BenSuskins/display/design/print/case-exploded.png

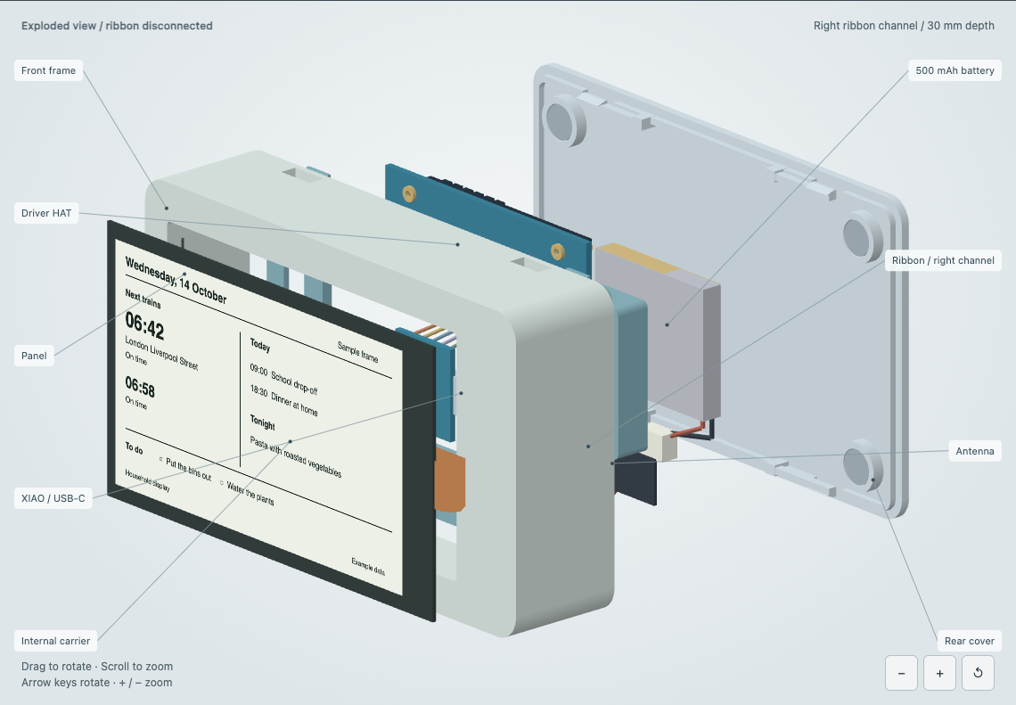
design/print/case-exploded.png
