BenSuskins/display/design/case-mockup.html

# Household display

A magnetic case. Three printed parts. One removable cover.

Fit prototype

## Inspect the case

FrontRearSideExploded Release slots

Transparent shellPart labelsClip section

## Fixed dimensions

120 × 74 × 30 mm

Outer width × height × depth

Panel and ribbon allowance: about 110 × 62 mm. The right border hides the ribbon channel.

What needs a measurement?

The glass body is 105.33 × 62.37 mm. Its visible area is 92.8 × 55.68 mm. The model uses the drawing’s offset.

Confirm header plugs, wire bends, the ribbon route, antenna size, and battery connector before CAD.

The 30 mm depth includes both walls. It does not prove the assembled hardware fits.

## Inside the case

- Front frame
- Internal carrier
- Rear cover
- Driver HAT and XIAO
- Panel ribbon
- 500 mAh battery

## Access from the rear

Remove the device from the fridge. Insert a small plastic tool through each release slot. Press the clip toward the centre and lift the cover edge. Two slots sit on top; two sit underneath. Open the cover to reach USB-C, RESET, and BOOT. The carrier holds the panel and electronics.

Clip sizes and magnet strength need checks for the chosen print material. The printed parts in this view use the exported CAD geometry. Validate the first print before fitting the panel.

Perspective viewRight ribbon channel / 30 mm depth

Drag to rotate · Scroll to zoom
Arrow keys rotate · + / − zoom

−+↺

## Case assembled

Step 6 of 6

PartsPanelCarrierElectronicsCoverLocked

Previous Play assemblyNextResetOpen cover

Copy design brief

## How the cover clip works

Close

### Clip locked

The hook sits behind the retaining ledge. The arm returns to its resting position.

Close clipRelease clipReplay closure

Section enlarged for clarity. The CAD clip has a long arm along the cover edge. This section illustrates the hook movement. The print material sets the final dimensions and clearance.
