BenSuskins/display/design/print/low-material/case-exploded.png

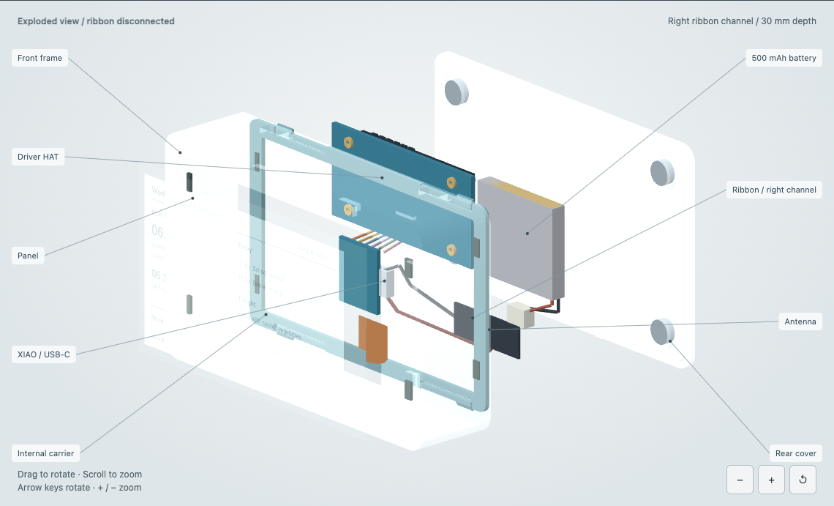
design/print/low-material/case-exploded.png
