BenSuskins/display/design/print/low-material/case-rear.png

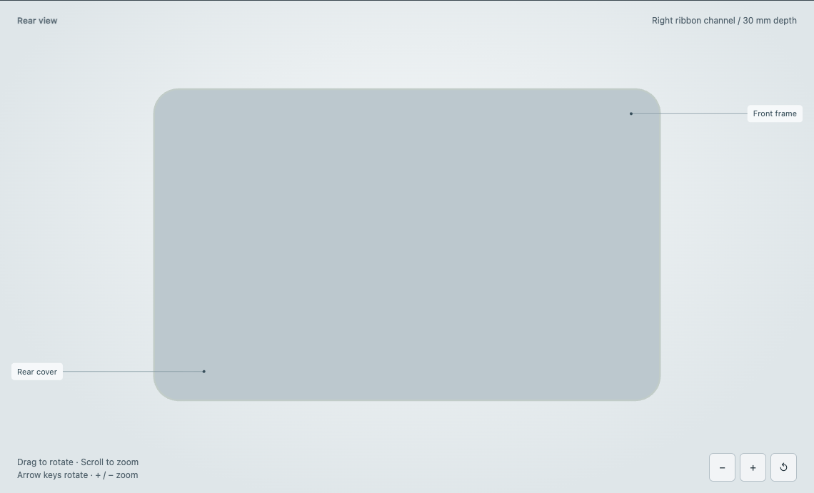
design/print/low-material/case-rear.png
