BenSuskins/display/design/print/low-material/case-assembly.step

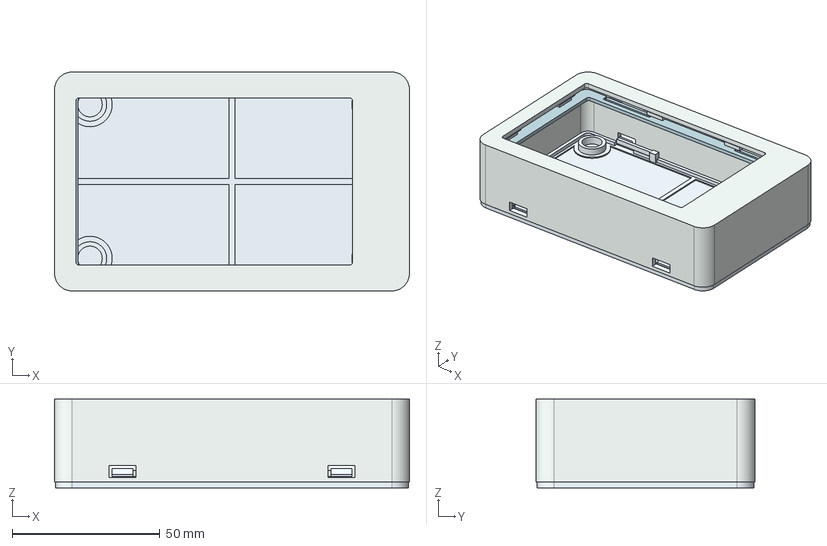
[picture p4: CAD file, 2026-10-15]
design/print/low-material/case-assembly.step
120.0 x 74.0 x 30.0 mm
front-frame
internal-carrier
rear-cover
