BenSuskins/display/design/print/case-assembly.step

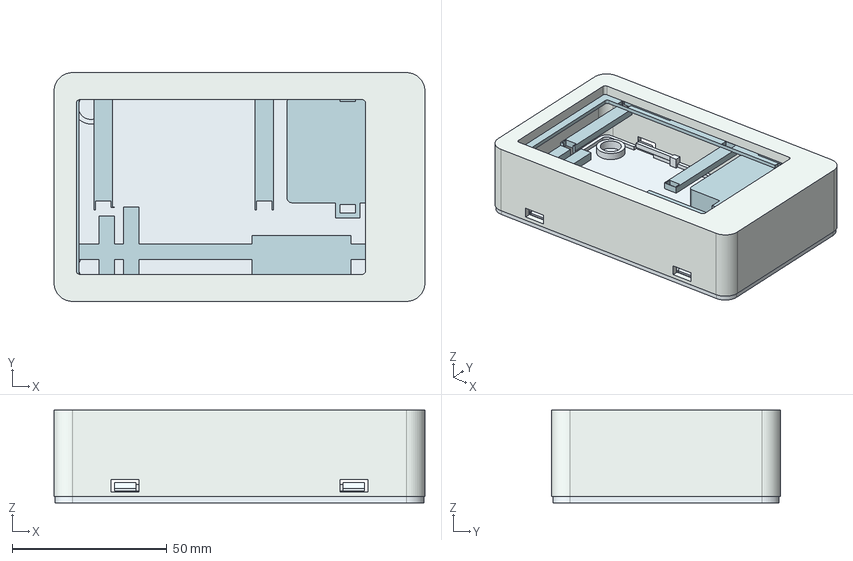
[picture p5: CAD file, 2026-10-14]
design/print/case-assembly.step
120.0 x 74.0 x 30.0 mm
front-frame
internal-carrier
rear-cover
