BenSuskins/display/design/print/all-parts.stl

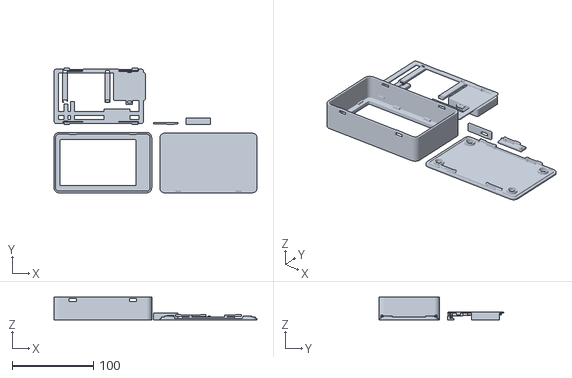
[picture p6: CAD file, 2026-10-14]
design/print/all-parts.stl
249.2 x 153.0 x 28.0
