BenSuskins/display/design/print/low-material/all-parts.stl

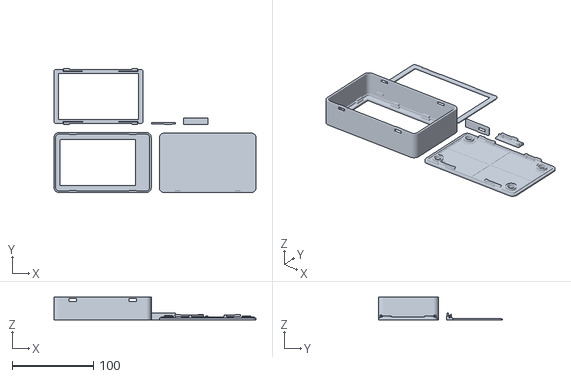
[picture p7: CAD file, 2026-10-15]
design/print/low-material/all-parts.stl
249.2 x 153.0 x 28.0
