BenSuskins/display/design/print/clip-coupon-cover.step

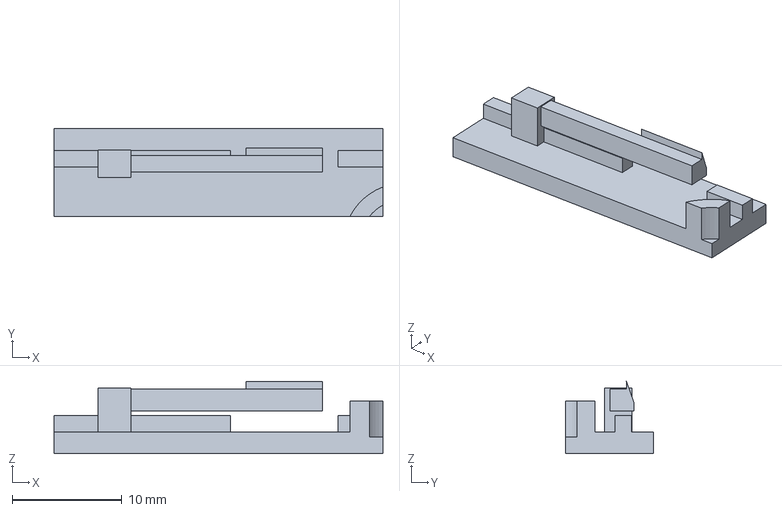
[picture p8: CAD file, 2026-10-14]
design/print/clip-coupon-cover.step
30.0 x 8.00 x 6.60 mm
