BenSuskins/display/design/print/low-material/front-frame.step

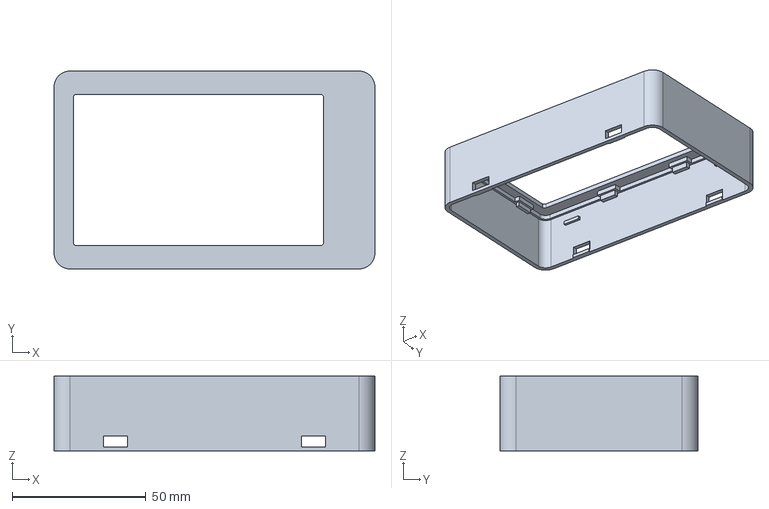
[picture p9: CAD file, 2026-10-15]
design/print/low-material/front-frame.step
120.0 x 74.0 x 28.0 mm
