BenSuskins/display/design/print/low-material/clip-coupon-frame.step

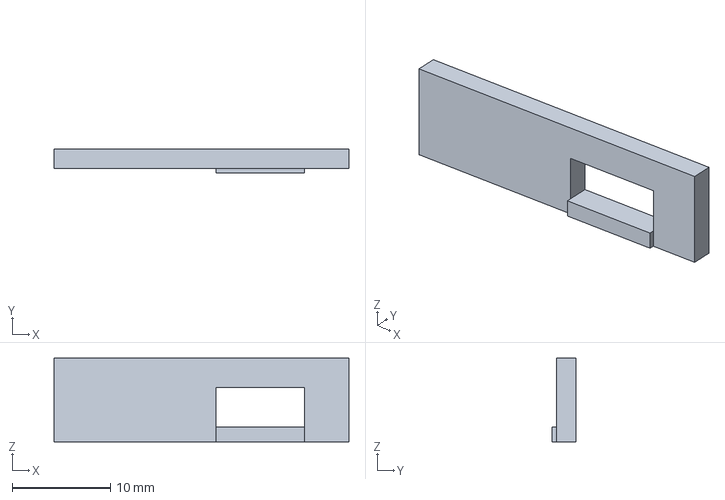
[picture p10: CAD file, 2026-10-15]
design/print/low-material/clip-coupon-frame.step
30.0 x 2.45 x 8.50 mm
