BenSuskins/display/design/print/rear-cover.step

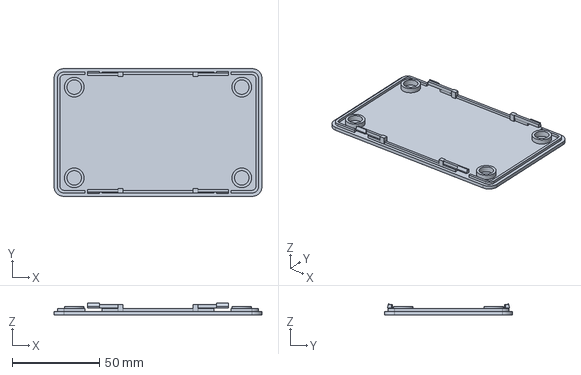
[picture p11: CAD file, 2026-10-14]
design/print/rear-cover.step
119.2 x 73.2 x 6.60 mm
