BenSuskins/display/design/print/internal-carrier.step

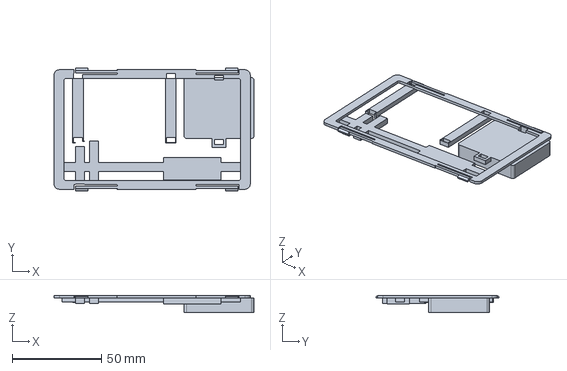
[picture p12: CAD file, 2026-10-14]
design/print/internal-carrier.step
112.1 x 69.0 x 9.80 mm
