BenSuskins/display/design/print/low-material/internal-carrier.step

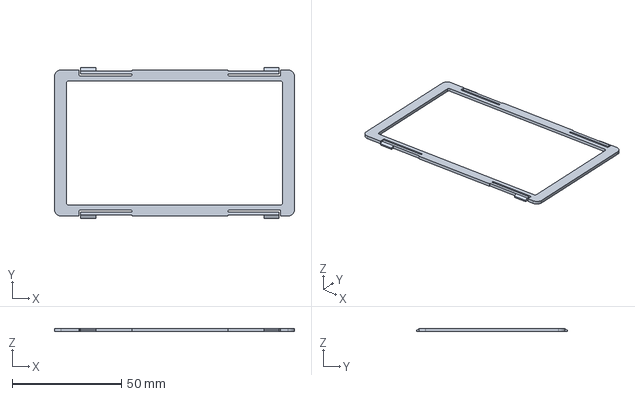
[picture p13: CAD file, 2026-10-15]
design/print/low-material/internal-carrier.step
110.0 x 69.0 x 1.50 mm
