BenSuskins/display/(list of files, cad)

Other CAD files:
design/print/clip-coupon-frame.step
design/print/low-material/rear-cover.step
design/print/front-frame.step
design/print/low-material/clip-coupon-cover.step
design/print/clip-coupon-cover.stl
design/print/front-frame.stl
design/print/internal-carrier.stl
design/print/low-material/clip-coupon-cover.stl
design/print/low-material/clip-coupon-frame.stl
design/print/low-material/front-frame.stl
design/print/low-material/internal-carrier.stl
design/print/low-material/rear-cover.stl
design/print/rear-cover.stl
