BenSuskins/display/design/print/case-preview.png

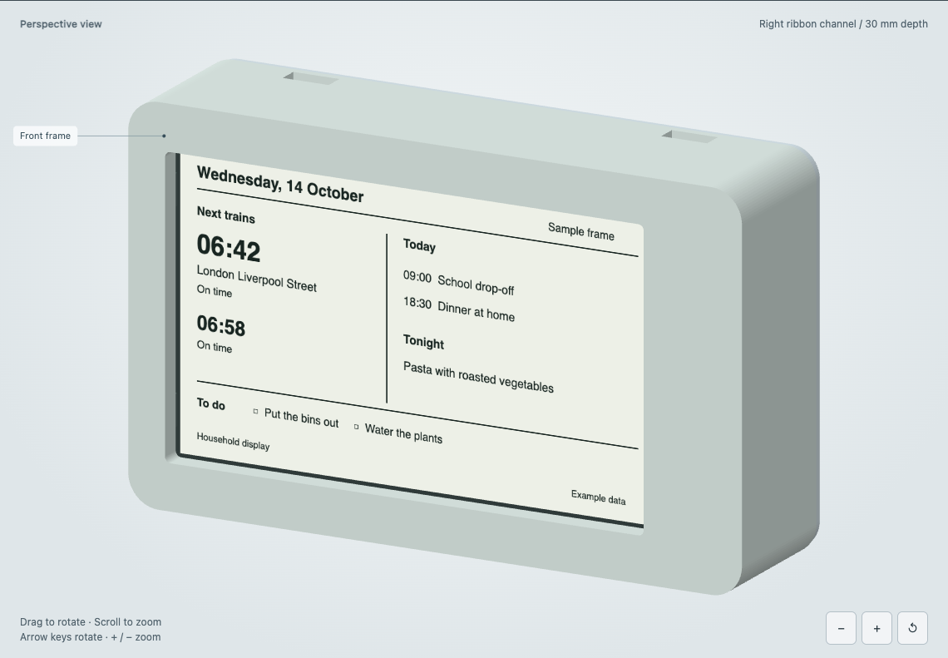
design/print/case-preview.png
