BenSuskins/display/apps/firmware/src/main.cpp

#include <Arduino.h>
#include <esp_sleep.h>
#include <esp_system.h>
#include <driver/gpio.h>
#include <gdeq/GxEPD2_426_GDEQ0426T82.h>

#include "DisplayPins.h"
#include "Frame.h"
#include "FrameClient.h"
#include "OfflineMarker.h"

// The whole of the Device's behaviour. It owns no layout, no schedule and no
// household data — it fetches a Frame, shows it, and sleeps for as long as the
// Render Service tells it to. See docs/adr/0001 and 0002.

// Caught here rather than at runtime: an unset environment variable expands to
// an empty string, and a device flashed with one fails in a way that looks like
// a network fault from across the room.
static_assert(sizeof(WIFI_SSID) > 1, "WIFI_SSID must be set when building");
static_assert(sizeof(WIFI_PASSWORD) > 1,
              "WIFI_PASSWORD must be set when building");
static_assert(sizeof(FRAME_URL) > 1, "FRAME_URL must be set when building");
static_assert(sizeof(DEVICE_TOKEN) > 1,
              "DEVICE_TOKEN must be set when building");

// Bisected on working hardware: 4 s truncates a full refresh and blanks the
// screen, 8 s completes it. Well above the observed edge, because e-ink slows
// as it cools and a truncated refresh fails silently.
constexpr uint32_t FullRefreshGuardMilliseconds = 12000;

// PROVISIONAL. The library claims 600 ms for a partial refresh, but BUSY tells
// us nothing on this HAT so it has never been bisected here. Run the
// partial_probe environment and replace this with a measured number before
// trusting the Offline Marker.
constexpr uint32_t PartialRefreshGuardMilliseconds = 3000;

constexpr uint32_t FailuresBeforeOfflineMarker = 3;
constexpr uint32_t FallbackSleepSeconds = 1800;
constexpr uint32_t MaximumSleepSeconds = 3600;

// Survives deep sleep. The etag is what makes a 304 possible, and losing it
// costs one unnecessary redraw, nothing worse.
RTC_DATA_ATTR char shownEtag[Frame::EtagCapacity] = {0};
RTC_DATA_ATTR uint32_t consecutiveFailures = 0;
RTC_DATA_ATTR bool offlineMarkerShown = false;
RTC_DATA_ATTR uint32_t wakeCount = 0;

// 48 KB in .bss. Talking to the driver directly rather than through GxEPD2_BW
// avoids a second buffer of the same size that we would never draw into.
static uint8_t frameBuffer[Frame::ByteLength];

GxEPD2_426_GDEQ0426T82 panel(DisplayPins::ChipSelect, DisplayPins::DataCommand,
                             DisplayPins::Reset, DisplayPins::Busy);

// The XIAO's RESET button is a usable Requested Wake without wiring anything:
// it pulls EN low, so the chip boots straight into a fetch and a render. It
// resets the RTC domain too, which clears the stored etag — so a reset press
// always redraws rather than getting a 304. That is the right behaviour for
// someone who just pressed refresh.
//
// The BOOT button cannot be used. It is GPIO9, outside the GPIO0-5 range the
// ESP32-C3 can wake from deep sleep on, and holding it at reset selects
// download mode instead of running this firmware.
const char *wakeCauseLabel() {
  switch (esp_sleep_get_wakeup_cause()) {
    case ESP_SLEEP_WAKEUP_GPIO:
      return "button";
    case ESP_SLEEP_WAKEUP_TIMER:
      return "timer";
    default:
      break;
  }

  return esp_reset_reason() == ESP_RST_POWERON ? "power on" : "reset";
}

// A Requested Wake from a button between D3 and GND.
//
// Off until WAKE_BUTTON_WIRED is defined, because arming a deep-sleep wake on an
// unconnected pin invites spurious wakes — a floating pin on this bench picks up
// mains hum. RESET remains the manual refresh either way and needs none of this.
//
// The pullup has to be held explicitly. pinMode(INPUT_PULLUP) configures the
// digital pad for normal operation only; without the hold it is not guaranteed
// through deep sleep, and an unheld pullup is the same as no pullup. The C3 has
// no rtc_gpio_pullup_en — that API does not exist on this chip.
void armButtonWake() {
#ifdef WAKE_BUTTON_WIRED
  constexpr gpio_num_t button =
      static_cast<gpio_num_t>(DisplayPins::WakeButton);

  gpio_pullup_en(button);
  gpio_pulldown_dis(button);
  gpio_hold_en(button);
  gpio_deep_sleep_hold_en();

  esp_deep_sleep_enable_gpio_wakeup(1ULL << button, ESP_GPIO_WAKEUP_GPIO_LOW);
#endif
}

// Pad holds survive the wake, so they have to be let go before anything is
// reconfigured — PanelPower in particular is driven low before sleeping.
void releaseHeldPins() {
#ifdef WAKE_BUTTON_WIRED
  gpio_deep_sleep_hold_dis();
  gpio_hold_dis(static_cast<gpio_num_t>(DisplayPins::WakeButton));
#endif
}

void powerPanelUp() {
  pinMode(DisplayPins::PanelPower, OUTPUT);
  digitalWrite(DisplayPins::PanelPower, HIGH);
  delay(100);

  // `initial` must be false. With it true, GxEPD2 sets _initial_write, and the
  // first writeImage silently calls clearScreen() — a whole extra full refresh
  // to white, which the library waits only full_refresh_time (1600 ms) for
  // because BUSY tells it nothing here. This panel needs ~8 s. Our image
  // refresh then lands 1.6 s into that clear and both are lost.
  //
  // Deep sleep restarts the sketch, so this object is fresh on every wake and
  // the fault would repeat on every redraw, not just the first.
  //
  // Skipping the clear is safe: we overwrite all 800x480 pixels anyway, and a
  // full refresh drives every pixel regardless of what was there.
  panel.init(115200, false, 10, false);
}

void showFrame() {
  // Writes the frame to both the previous and current controller buffers, so
  // one refresh leaves them equal — which is what a later partial refresh, and
  // therefore the Offline Marker, differentiates against.
  panel.writeImageForFullRefresh(frameBuffer, 0, 0, Frame::Width,
                                 Frame::Height);
  panel.refresh(false);
  delay(FullRefreshGuardMilliseconds);
}

void stampOfflineMarker() {
  // Tell the controller what was there before, because after a cold power-up it
  // has no idea and a partial refresh is differential. See OfflineMarker.h.
  panel.writeImageToPrevious(OfflineMarker::WhiteTile, OfflineMarker::X,
                             OfflineMarker::Y, OfflineMarker::Width,
                             OfflineMarker::Height);
  panel.writeImage(OfflineMarker::Bitmap, OfflineMarker::X, OfflineMarker::Y,
                   OfflineMarker::Width, OfflineMarker::Height);
  panel.refresh(OfflineMarker::X, OfflineMarker::Y, OfflineMarker::Width,
                OfflineMarker::Height);
  delay(PartialRefreshGuardMilliseconds);

  offlineMarkerShown = true;
  Serial.println("panel: offline marker stamped");
}

void sleepFor(uint32_t seconds) {
  const uint32_t bounded =
      seconds == 0 ? FallbackSleepSeconds
                   : (seconds > MaximumSleepSeconds ? MaximumSleepSeconds
                                                    : seconds);

  panel.hibernate();
  digitalWrite(DisplayPins::PanelPower, LOW);

  armButtonWake();
  esp_sleep_enable_timer_wakeup(static_cast<uint64_t>(bounded) * 1000000ULL);

  Serial.printf("sleeping %lu s (awake %lu ms)\n", bounded, millis());
  Serial.flush();
  esp_deep_sleep_start();
}

void setup() {
  Serial.begin(115200);
  delay(200);
  releaseHeldPins();

  wakeCount += 1;
  Serial.printf("\nwake %lu (%s) build %s %s\n", wakeCount, wakeCauseLabel(),
                __DATE__, __TIME__);

  if (!FrameClient::joinNetwork(WIFI_SSID, WIFI_PASSWORD)) {
    consecutiveFailures += 1;
    powerPanelUp();
    if (consecutiveFailures >= FailuresBeforeOfflineMarker &&
        !offlineMarkerShown) {
      stampOfflineMarker();
    }
    sleepFor(FallbackSleepSeconds);
  }

  const FrameResponse response = FrameClient::fetchFrame(
      FRAME_URL, DEVICE_TOKEN, shownEtag, frameBuffer, Frame::ByteLength);
  FrameClient::leaveNetwork();

  switch (response.outcome) {
    case FetchOutcome::Rendered:
      consecutiveFailures = 0;
      powerPanelUp();
      showFrame();
      strlcpy(shownEtag, response.etag, Frame::EtagCapacity);
      offlineMarkerShown = false;
      break;

    case FetchOutcome::Unchanged:
      // The cheap path, and the common one: no panel power, no refresh guard.
      consecutiveFailures = 0;
      Serial.println("panel: unchanged, skipping refresh");
      break;

    case FetchOutcome::Failed:
      consecutiveFailures += 1;
      Serial.printf("fetch failed (%lu in a row)\n", consecutiveFailures);
      if (consecutiveFailures >= FailuresBeforeOfflineMarker &&
          !offlineMarkerShown) {
        powerPanelUp();
        stampOfflineMarker();
      }
      break;
  }

  sleepFor(response.nextWakeSeconds);
}

void loop() {}
