BenSuskins/display/(commit log)

2026-08-05 Add e-ink display bring-up for XIAO ESP32-C3 + Waveshare 4.26"
    PlatformIO project driving a Waveshare 4.26" 800x480 b/w panel via a
    Driver HAT rev2.3 using GxEPD2.
    Established so far:
    - PWR (HAT pin 12) must be driven high from D5 before the panel responds
    to anything. A floating enable makes every other symptom intermittent.
    - BUSY is unusable on this hardware: it reads a constant low whenever the
    panel is powered, so GxEPD2 polling returns immediately. Pinned to -1
    and refresh completion is gated by a fixed delay instead.
    - No brownout; the ESP completes a full render cycle cleanly.
    Outstanding: the panel refreshes but receives no image data, so
    fillScreen(BLACK) still lands on whi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
    [DisplayPins.h, main.cpp]
2026-08-05 Add README
    Status, hardware, wiring table, build commands, and the non-obvious
    findings from bring-up: PWR must be driven, BUSY is unusable, and an
    unchanged e-ink screen is not evidence a render succeeded.
    Claude-Session: https://claude.ai/code/session_011L8yAMgag92eoUrTM27x8D
2026-08-05 Working timer-driven e-ink display
    First end-to-end working state: renders on a 60s deep-sleep timer cycle
    with a wake counter surviving in RTC memory.
    Repinned to the production map. Control lines moved off D0-D3 so those
    stay available as deep-sleep wake sources, since the ESP32-C3 only wakes
    on GPIO0-GPIO5. D0 left unused because GPIO2 is a boot strapping pin and
    a button pulling it low at reset can force download mode.
    Refresh timing bisected on working hardware: 4s truncates the refresh and
    blanks the screen, 8s completes it. Committed at 12s, well above the
    observed edge, because e-ink slows as it cools and a truncated refresh
    fails silently — stale image, nothing in the logs.
    Awa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
    [DisplayPins.h, main.cpp]
2026-08-05 Add layout prototype: eight demo pages for type, tone and symbols
    Cycles through eight pages to work out what actually reads well on this
    panel before committing to a dashboard design: a typography ladder with
    measured ink heights, a comparison of the two routes past 24pt, shape and
    rule primitives, dither and hatch tone, a drawn symbol set, two dashboard
    mockups and chart marks.
    Page renderers take Adafruit_GFX rather than the GxEPD2 template, so layout
    code is independent of the panel and its paging loop.
    No deep sleep here. Holding PanelPower high for the whole session removes
    the truncated-refresh failure mode that the 12 s guard delay exists for, so
    pages can follow each other as fast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
    [DemoPage.h, DemoPages.cpp, main.cpp]
2026-08-08 Add contrast probe and document the Display Config switch finding
    A washed-out panel traced to the HAT's Display Config switch selecting the
    higher current-limiting resistor for the panel's boost converter. The starved
    booster underdrives the drive waveform, which kills hairlines, small text and
    dither while leaving large solid fills looking fine. The demo pages are almost
    entirely fine detail, so it showed up as unexplained general fadedness.
    The probe renders solid fields, which the demo pages structurally cannot: a
    solid black page, and the same page with a white box swept across three
    positions. That exposed a full-height pale band on whichever columns carried
    switching content, and the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
2026-08-08 Add the Render Service domain and the Huxley2 departure source
    Design decision: the ESP32 stops composing images. A TypeScript service
    aggregates household data, lays the page out in HTML/CSS and serves a
    48,000-byte 1-bit frame; the device blits it and sleeps. That moves layout,
    data and scheduling to a deployable, so changing the design stops meaning
    reflashing a battery device on a fridge. Recorded in docs/adr/.
    Domain so far:
    - Catchable Departure — the next trains you could still make if you left now,
    filtered on the earliest a train can possibly leave rather than its booked
    time, so a delay that buys you time keeps the train on screen.
    - Wake schedule — the service tells the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
2026-08-08 Add the rasteriser, the frame endpoint and a deployable container
    The pipeline now runs end to end: HTML in a headless Chromium, thresholded to
    one bit per pixel, packed into the panel's native RAM format and served over
    HTTP with the sleep duration the device should obey.
    - packMonochrome — a set bit is white, most significant bit leftmost, which is
    what GxEPD2 expects (its clearScreen defaults to 0xFF for white), so the
    device hands the buffer straight to writeImage without touching it. Rows pad
    with white rather than black so an odd width can never draw a sliver.
    - rasteriser — Chromium is launched once and kept, because launching costs far
    more than rendering does. Playwrigh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
2026-08-08 Rewrite the firmware as a frame client, add the offline marker
    The device now does one thing per wake: join Wi-Fi, ask for a frame, write it
    to the panel if it changed, sleep for as long as the server said. No layout, no
    schedule, no clock, no household data — ADR-0001 and ADR-0002 made concrete.
    Talks to the GxEPD2 driver class directly rather than through GxEPD2_BW, which
    statically allocates its own 48 KB page buffer. On top of the downloaded frame
    that would be 96 KB of a 320 KB heap, for a buffer we never draw into. Build is
    26.8% RAM as it stands.
    - The etag lives in RTC memory, so an unchanged frame is a 304 and the panel
    refresh — and its 12 s blind guard — is skipped entir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
    [DemoMain.cpp, Frame.h, FrameClient.cpp, FrameClient.h, OfflineMarker.h, PartialRefreshProbe.cpp, main.cpp]
2026-08-08 Make the published host port configurable
    The container listens on 8080, but the host port it is published on is a
    deployment choice — and it is the one the device's FRAME_URL has to match.
    Hardcoding 8080 meant any other choice silently pointed the device at nothing.
    Claude-Session: https://claude.ai/code/session_01LEFtmreWUpF69a5c2e2E1y
2026-08-08 Fix the frame identity ticking with the wall clock
    The etag was a hash of the rendered bytes, and the footer prints "rendered
    HH:MM". Every minute produced a different etag, so If-None-Match would never
    have matched and the device would have redrawn on every wake — losing the
    entire battery argument for waking often that ADR-0002 rests on. The battery
    voltage in the footer did the same thing.
    Found from a live response header, not from the tests: every existing test
    injects a fixed clock, and the earlier manual curl check happened to run twice
    inside the same minute.
    The identity is now a hash of the page rendered at local midnight with the
    battery omitted, so the date still counts but t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
2026-08-08 Fix the blank panel: GxEPD2 was issuing a hidden second refresh
    The panel stayed blank on the first hardware run. Cause was init(115200, true,
    2, false): the `initial` argument sets _initial_write, and GxEPD2's _writeImage
    then silently calls clearScreen() before writing anything — an entire extra
    full refresh to white. The library waits full_refresh_time (1600 ms) for it,
    because BUSY carries no signal on this HAT and _waitWhileBusy falls back to a
    fixed delay. This panel needs about 8 s. So the clear was truncated and our
    image refresh landed 1.6 s into it, losing both.
    Deep sleep restarts the sketch, so the driver object is fresh on every wake and
    this would have repeated on every redr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
    [OfflineMarker.h, main.cpp]
2026-08-08 Drop the battery reading from the display
    It was never populated — the XIAO C3 has no divider from the battery pads to an
    ADC pin — and a reading that drifted every wake would have changed the frame's
    identity and cost a redraw every time, which is the same trap the footer clock
    set. The server still accepts ?battery= and still stretches the sleep interval
    when it is low; that is a scheduling input, not something to look at.
    batteryVolts therefore leaves the view model entirely rather than lingering
    unused, which also simplifies the frame identity: it now only has to hold the
    clock still.
    Also report the wake cause honestly. The XIAO's RESET button works as a manual
    refresh with no wir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
    [main.cpp]
2026-08-08 Gate button wake behind a flag, and hold its pullup properly
    Two things were wrong with arming a deep-sleep wake on D3.
    Nothing is connected to it, so the pin floats — and this bench is already
    documented as picking up mains hum on floating pins. A spurious wake costs a
    full fetch for nothing. It is now off unless WAKE_BUTTON_WIRED is defined.
    More subtly, pinMode(INPUT_PULLUP) configures the digital pad for normal
    operation and is not guaranteed to survive deep sleep, so the pullup that was
    supposed to keep the pin high while sleeping may not have been there at all.
    The C3 has no rtc_gpio_pullup_en — that API does not exist on this chip, which
    is worth recording because it is the obvi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
    [main.cpp]
2026-08-08 Drop the stale build section: the default env is no longer the prototype
    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
2026-08-08 Wire the Met Office and Family Hub sources
    All four remaining zones now carry real data: weather in the header and a rain
    line under the trains, today's calendar, tonight's dinner and chores due with
    an overdue count.
    Both are optional. A missing token leaves that source reporting itself
    unconfigured and its zone saying so, rather than the service refusing to boot
    and taking the working trains display down with it. That is the same
    degrade-one-zone-at-a-time rule the Result type exists for.
    Field names were read off the real systems rather than guessed:
    - Family Hub's Go models carry no json tags, so they marshal as PascalCase
    (Name, AssignedToUserID, StartTime) while the dashboard's ow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
2026-08-08 Fix departures landing an hour late in British Summer Time
    At 16:04 with trains at 16:22 and 16:54, the panel showed 17:22 — everything
    shifted by exactly the BST offset.
    The parser anchored bare "HH:MM" departure times to the board's own generatedAt
    and recovered the local offset by regex-matching a trailing +01:00 on it.
    Huxley2 passes through a .NET DateTime that can serialise with no offset at
    all; the regex then returned zero while JavaScript had already parsed the
    offsetless string as local time. The offset was absorbed once and assumed to be
    zero, so every departure landed an hour late.
    Departures are now placed against the caller's clock, which the composer
    already holds and whic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
2026-08-08 Rework the bottom bands so the overdue count cannot be squeezed out
    A real feed had "Clean Top of Cupboards - Ben Suskins", wide enough to wrap the
    chores row and push the overdue count past the bottom of a fixed height band.
    The earlier fix only held because the sample data had short names.
    Three changes, only one of which is cosmetic:
    - The overdue count moves into the Chores heading, right aligned. Its position
    can no longer be affected by how long the chore names are, which is the
    structural fix; the rest is padding.
    - The rendered time moves up beside the date, as suggested, and the footer row
    goes entirely. That returns 32px to the bands, which now fit two rows of
    chores.
    - A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
    [OfflineMarker.h]
2026-08-08 Show trains only during the commute, and the weather after it
    A departure board is worth the best zone on the fridge between six and nine
    and worth nothing at all by lunchtime, when every train on it has gone. So
    the left column now belongs to whichever Daypart it is: the board during the
    commute window, the weather at the size the departures had for the rest of
    the day.
    Only that zone changes. The header, the agenda, dinner and chores sit exactly
    where they were, so reading the fridge at 09:05 is not a matter of finding
    everything again. The header does drop its weather line in the day Daypart —
    the same three numbers printed small an inch above a large copy of themselves
    is a duplicate,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
2026-08-08 Reorganise into apps/, and adopt the shared repo conventions
    The two components were nested asymmetrically: the firmware's src/, include/
    and platformio.ini sat at the repo root — because PlatformIO defaults to those
    names — while the Render Service lived in server/. Root src/ read as "the
    repo's source" when it was one of two halves.
    Both now live under apps/, and the demo prototype is self-contained in
    apps/firmware/src/demo/ so the firmware build excludes a directory rather than
    naming files. DemoPage.h moves there too, leaving include/ to the real firmware.
    Docs follow the bensuskins/* convention from repo-templates: root holds LICENSE
    and .github/, and docs/ holds the pages GitHub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
2026-08-09 Show the week ahead, and tomorrow's weather
    Both data columns now run "now" over "next". The calendar column keeps
    today's entries and gains the next seven days beneath them; the weather
    zone keeps the current reading and gains tomorrow.
    The lower half of each is terser on purpose. The week ahead is a line per
    day rather than a row per event — seven days of a household calendar do
    not fit as rows, and the question it answers is which evenings are
    already spoken for, not what is at 16:30 on Thursday. Tomorrow is a high,
    a low and whether it rains, which is what you need to pack a bag tonight.
    Everything on the Panel had to give a few pixels for it, so what no
    longer fits is counted in the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
2026-10-14 Add printable display case and interactive CAD preview
2026-10-14 Add combined STL for all case parts
2026-10-15 Reduce case material and simplify the screen carrier
